NTUEE-ESLab/2018Fall-PointBlank/presentation.pdf

# PointBlank

### B04901036 林厚均 B04901165 陳致維

# Outline

### - Motivation - Goals - Methods

- Qt (for GUI)
- Bluetooth Low Energy (for communication)
- Motion Sensor (for mouse position)

### - Results - Reference

# Motivation

### - Replace traditional laser pointer - Safer and more versatile - Inspired by a commercial product

# Goals

### - Determine pointer’s projection on screen without cameras and physical (light) markers - Basic functions of a presentation pointer

- Next slide
- Previous slide
- Display the position of the projection

### - Additional features

- Control mouse position
- Simulate mouse click
- Act as magnifying glass
- Customization

# Methods (GUI)

### - Using Qt - Creates a full screen transparent window that ignores keyboard and mouse inputs - Receives coordinates from the pointer and draws on the screen according to the current mode - Also provides user interface for customization as a seperate program

# Four modes (1)

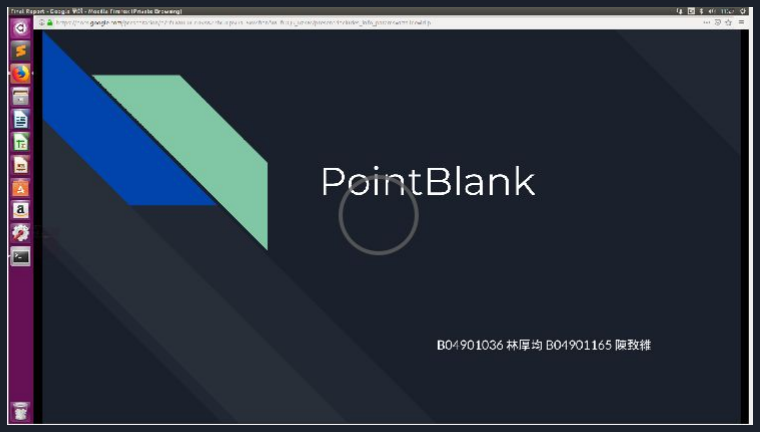
[picture p15: figure]

### 1. drawEllipse()

- center coordinates, radius
- using pen width, pen color

# Four modes (2)

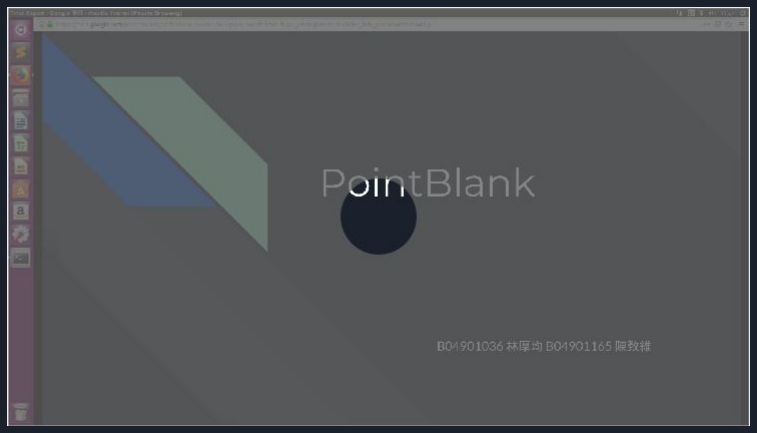
[picture p16: figure]

### 1. fillRect()

- fill the whole screen with color

### 2. drawEllipse()

- fill with color (0,0,0,0)
- full transparent circle around mouse position

# Four modes (3)

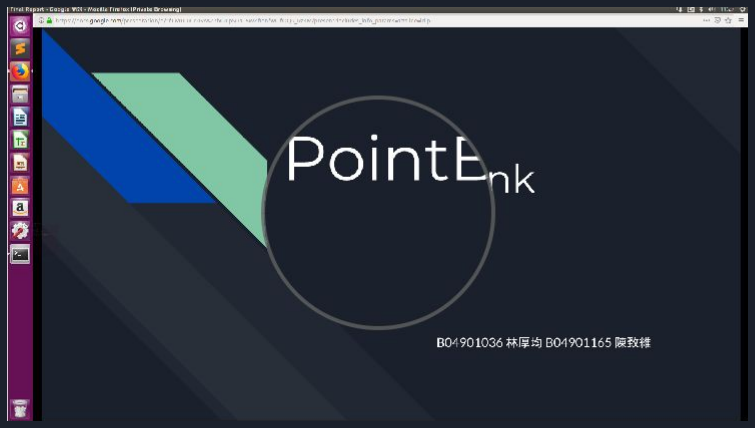
[picture p17: figure]

### 1. grabWindow()

- take screenshot when button is pressed

### 2. scale and reposition the image 3. setClipRegion

- the scaled image only appears inside the circle

# Four modes (4)

### - The previous modes are for slideshows

- their left and right buttons correspond to keyboard UP and DOWN respectively

### - This mode simulates mouse function

- with mouse left click and right click

# Customization

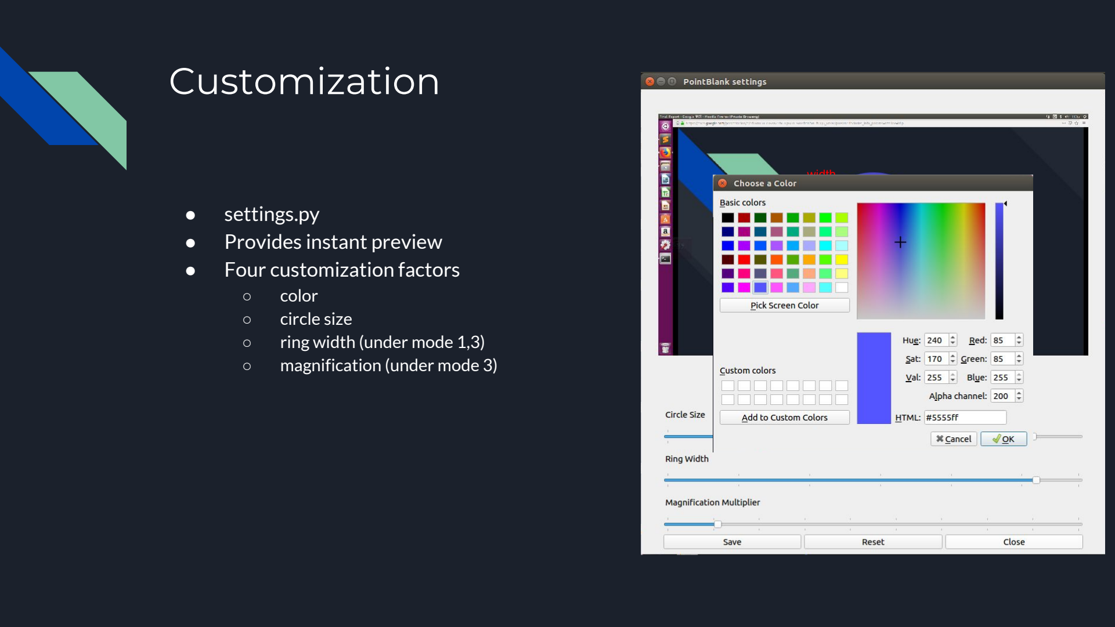
[picture p18: page 10]

### - settings.py - Provides instant preview - Four customization factors

- color
- circle size
- ring width (under mode 1,3)
- magnification (under mode 3)

size

width

# Methods (Bluetooth)

### - Using Qt for central

- Discover advertising Raspberry Pi and connect to it
- Enable notifications for Position and Buttons characteristics
- Update GUI whenever a notification is received

### - Using bluez for peripheral

- Advertisement
- Service: PointBlank
- Characteristics: Position, Buttons
- Position returns (x, y) with x and y being floats between 0 and 1
■ referring to the boundaries of the screen
- Buttons returns an integer indicating which button is pressed or released

# Establishing Bluetooth Connection

### 1. QBluetoothDeviceDiscoveryAgent.start()

- Search for nearby low energy services

### 2. QLowEnergyController.connectToDevice()

- connnect to device with service uuid “00003125-0000-1000-8000-00805f9b34fb”

### 3. QLowEnergyController.discoverServices() 4. QLowEnergyService.discoverDetails()

- For each service, in this case we only have one

### 5. Write “0x0100” to the descriptors of Position and Buttons characteristic

- to enable notification

# Methods (Motion Sensor)

### - MPU9250 - Self-defined operation state:

- Sleep: all sensor power off
- Active: read gyroscope and accelerometer at ~500Hz
- Switch by button

### - Data process:

- Represent orientation: frame and transformation
- Update orientation: 6-axis data fusion
- Initialize orientation
- Reduce vibration: vibration from hand and sensor noise

# Orientation Representation

### - Recording the difference between

- Sensor frame
- Earth frame

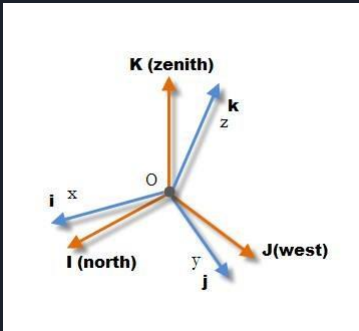
[picture p19: figure]

### by some representation

### - Rotation matrix The same as recording the three axes of earth frame in sensor frame

### - Numerical error Cannot ensure the three axes keep perpendicular to each other after several update

# Roll-Pitch-Yaw (Euler Angles)

### - Simple representation three rotations apply on x, y, z axis sequentially

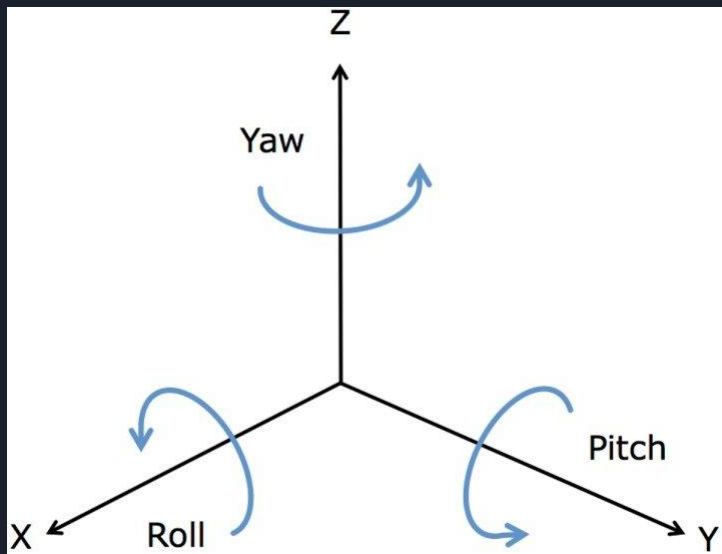
[picture p20: figure]

### - Consistent to gyroscope output

### - Computational demanding: one vector transformation needs

- three rotation matrix multiplication
- and lots of sine, cosine computation

# Quarternion

### - Euler rotation theorem: Any 3D rotation can be represent as a rotation along some axis

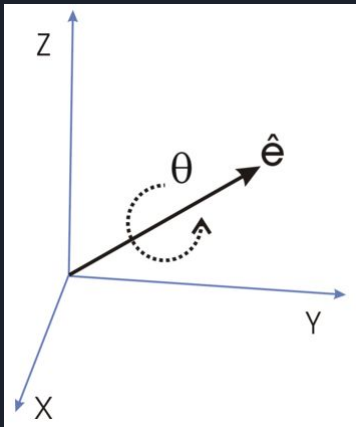
[picture p21: figure]

### - Quarternion catch this property by an indirect way: [cos θ/2, ex

### sin θ/2, ey

### sin θ/2, ez

### sin θ/2]

### - All rotation operations become linear

- operations like rotation matrix
- smaller numerical error
- faster computation

# Quarternion Operation

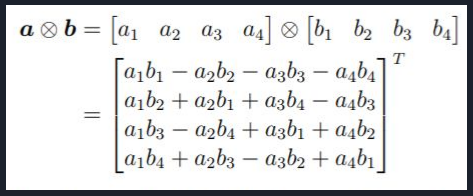
[picture p22: figure]

### - Extention of complex number:

- i²

= j²

= k²
= -1
- ij = k
- [w, x, y, z] = w + xi + yj + zk
- a* = [a1

, -a2

, -a3

, -a4

]

### - Unit quarternion and 3D rotation are isomorphic:

- | Quarternion | can represent rotation from
frame A to frame B

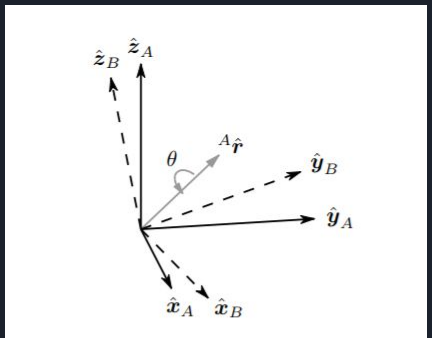
[picture p23: figure]

- sequential:
- | transformation: | , | , v = [0, v1 , v2

, v3

]
- | backward: | q*

### - Both Unity and OpenGL support quarternion

# Update Orientation

### - 6-axis data fusion

- Gyroscope has drift problem from integral
- Accelerometer itself cannot generate a sensor frame

### - Madgwick orientation filter

- Quarternion representation
- use fixed vector (gravity) to adjust gyroscope

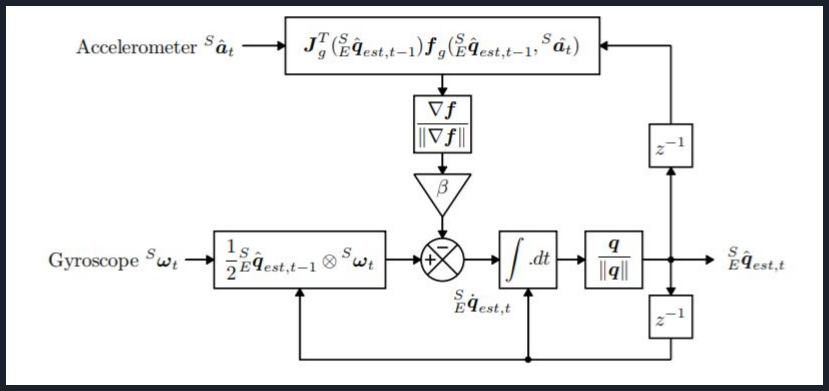
[picture p24: figure]

# Initialize Orientation

### - Problem

- Madgwick filter assumes gravity is on positive z-axis
- Correlation between initial sensor frame and horizontal movement

### - Goal

- Pointer usage is independent of pitch angle and roll angle
- x-axis: front direction (pointer direction)
- y-axis: horizontal direction
- z-axis: vertical direction

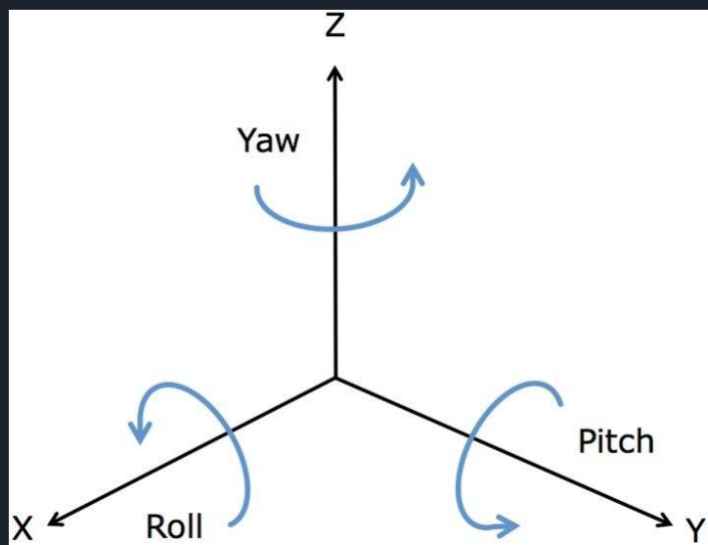
[picture p25: figure]

# Initialize Orientation (Cont.)

### - Add a beginning body frame - From sensor frame to beginning frame: roll angle

- horizontal direction: outer product of pointer direction and gravity
- compute the angle between y-axis and horizontal direction
- correct roll angle

### - From beginning frame to earth frame: pitch angle

- compute the angle between z-axis and vertical direction (gravity)
- correct pitch angle

### - Update sensor-to-earth quarternion by Madgwick filter - Compute the difference between pointer direction and beginning direction in beginning frame

# Reduce Vibration

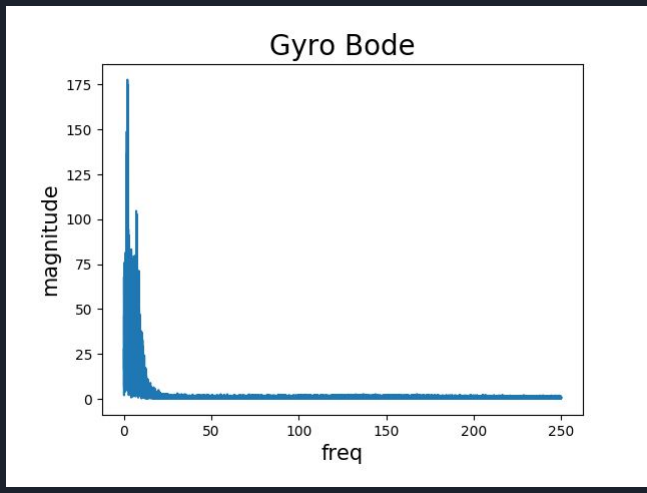
[picture p26: figure]

### - Problem

- Hand natural vibration (1~10Hz)
- Sensor white noise

### - Goal

- Minimize the vibration of the pointer output
- Reasonable response time (negligible delay)
- Trade-off

### - Solution

- SImple first order IIR filter
- output[n] = 0.02 * input[n] + 0.98 * output[n-1]
- Reduce ~70% vibration
- Delay: ~0.1s

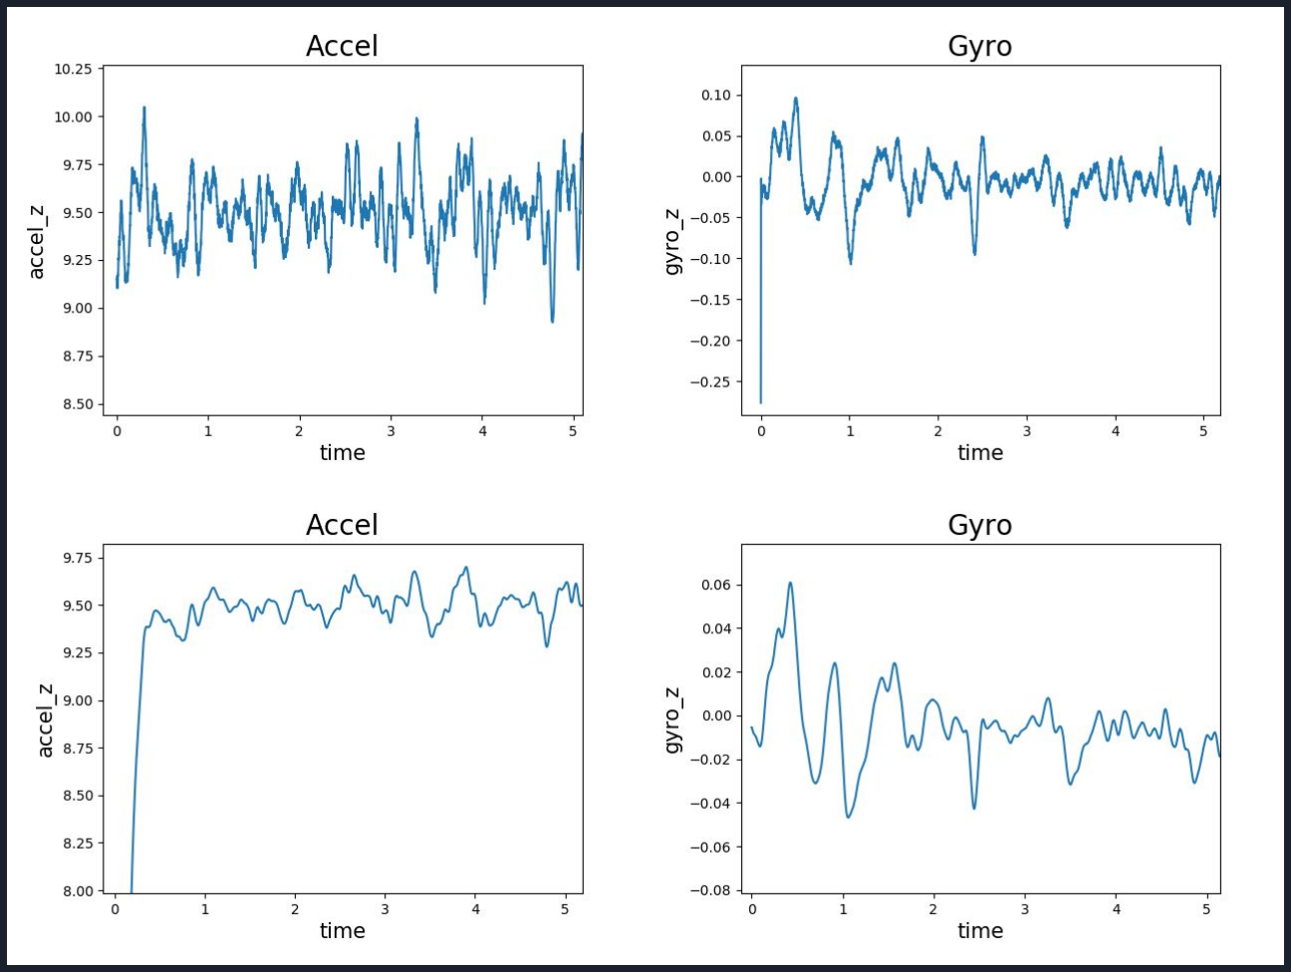
[picture p27: figure]

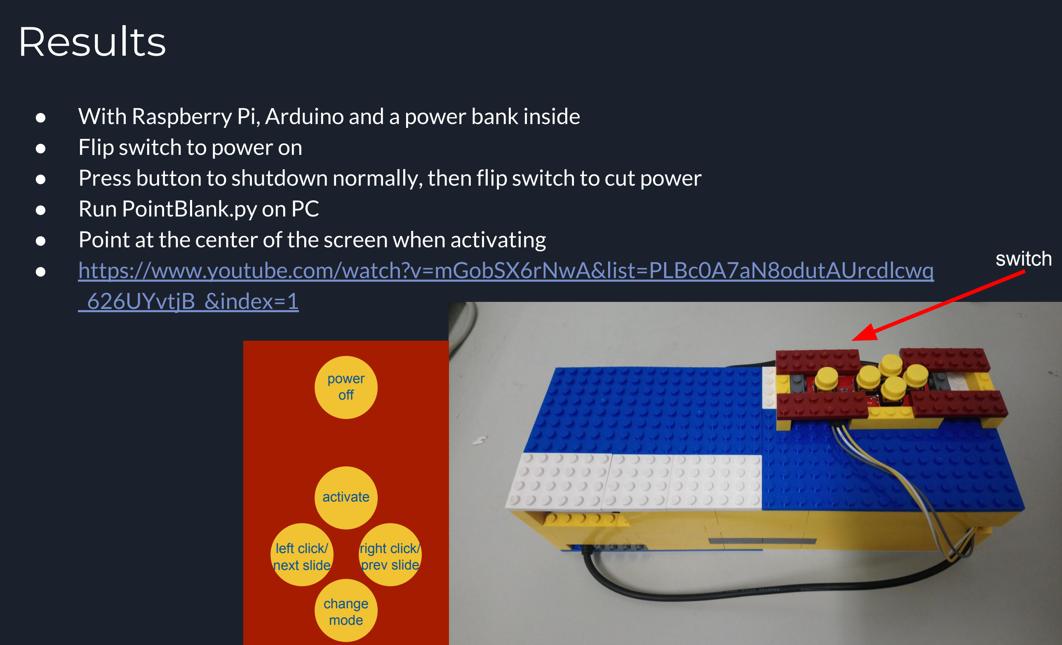
[picture p28: figure]
● Flip switch to power on; ● Run PointBlank.py on PC; _626UYvtjB_&index=1; Results; power off; change mode; left click/ next slide; right click/ prev slide; activate; switch

### - With Raspberry Pi, Arduino and a power bank inside

### - Press button to shutdown normally, then flip switch to cut power

### - Point at the center of the screen when activating - https://www.youtube.com/watch?v=mGobSX6rNwA&list=PLBc0A7aN8odutAUrcdlcwq

# Reference

### - http://doc.qt.io/ - Example codes in bluez folder - MPU 9250 Datasheet - Sebastian O. H. Madgwick, “Estimation of IMU and MARG orientation using a gradient descent algorithm”, 2011 IEEE International Conference on Rehabilitation Robotics

# Thank you for your attention
