NTUEE-ESLab/2018Fall-PointBlank/rpi/bluez_example.py

#!/usr/bin/python

import dbus
import dbus.exceptions
import dbus.mainloop.glib
import dbus.service

import array
import gobject

import random
import struct

BLUEZ_SERVICE_NAME = 'org.bluez'
LE_ADVERTISING_MANAGER_IFACE = 'org.bluez.LEAdvertisingManager1'
DBUS_OM_IFACE = 'org.freedesktop.DBus.ObjectManager'
DBUS_PROP_IFACE = 'org.freedesktop.DBus.Properties'

LE_ADVERTISEMENT_IFACE = 'org.bluez.LEAdvertisement1'

GATT_MANAGER_IFACE = 'org.bluez.GattManager1'

GATT_SERVICE_IFACE = 'org.bluez.GattService1'
GATT_CHRC_IFACE =    'org.bluez.GattCharacteristic1'
GATT_DESC_IFACE =    'org.bluez.GattDescriptor1'

class InvalidArgsException(dbus.exceptions.DBusException):
    _dbus_error_name = 'org.freedesktop.DBus.Error.InvalidArgs'

class NotSupportedException(dbus.exceptions.DBusException):
    _dbus_error_name = 'org.bluez.Error.NotSupported'

class NotPermittedException(dbus.exceptions.DBusException):
    _dbus_error_name = 'org.bluez.Error.NotPermitted'

class InvalidValueLengthException(dbus.exceptions.DBusException):
    _dbus_error_name = 'org.bluez.Error.InvalidValueLength'

class FailedException(dbus.exceptions.DBusException):
    _dbus_error_name = 'org.bluez.Error.Failed'


class Advertisement(dbus.service.Object):
    PATH_BASE = '/org/bluez/example/advertisement'

    def __init__(self, bus, index, advertising_type):
        self.path = self.PATH_BASE + str(index)
        self.bus = bus
        self.ad_type = advertising_type
        self.service_uuids = None
        self.manufacturer_data = None
        self.solicit_uuids = None
        self.service_data = None
        self.local_name = None
        self.include_tx_power = None
        dbus.service.Object.__init__(self, bus, self.path)

    def get_properties(self):
        properties = dict()
        properties['Type'] = self.ad_type
        if self.service_uuids is not None:
            properties['ServiceUUIDs'] = dbus.Array(self.service_uuids,
                                                    signature='s')
        if self.solicit_uuids is not None:
            properties['SolicitUUIDs'] = dbus.Array(self.solicit_uuids,
                                                    signature='s')
        if self.manufacturer_data is not None:
            properties['ManufacturerData'] = dbus.Dictionary(self.manufacturer_data, signature='qay')

        if self.service_data is not None:
            properties['ServiceData'] = dbus.Dictionary(self.service_data, signature='say')

        if self.local_name is not None:
            properties['LocalName'] = dbus.String(self.local_name)

        if self.include_tx_power is not None:
            properties['IncludeTxPower'] = dbus.Boolean(self.include_tx_power)

        return {LE_ADVERTISEMENT_IFACE: properties}

    def get_path(self):
        return dbus.ObjectPath(self.path)

    def add_service_uuid(self, uuid):
        if not self.service_uuids:
            self.service_uuids = []
        self.service_uuids.append(uuid)

    def add_solicit_uuid(self, uuid):
        if not self.solicit_uuids:
            self.solicit_uuids = []
        self.solicit_uuids.append(uuid)

    def add_manufacturer_data(self, manuf_code, data):
        if not self.manufacturer_data:
            self.manufacturer_data = dict()
        self.manufacturer_data[manuf_code] = data

    def add_service_data(self, uuid, data):
        if not self.service_data:
            self.service_data = dict()
        self.service_data[uuid] = data

    def add_local_name(self, name):
        if not self.local_name:
            self.local_name = ""
        self.local_name = dbus.String(name)

    @dbus.service.method(DBUS_PROP_IFACE,
                         in_signature='s',
                         out_signature='a{sv}')
    def GetAll(self, interface):
        print 'GetAll'
        if interface != LE_ADVERTISEMENT_IFACE:
            raise InvalidArgsException()
        print 'returning props'
        return self.get_properties()[LE_ADVERTISEMENT_IFACE]

    @dbus.service.method(LE_ADVERTISEMENT_IFACE,
                         in_signature='',
                         out_signature='')
    def Release(self):
        print '%s: Released!' % self.path

class Application(dbus.service.Object):
    """
    org.bluez.GattApplication1 interface implementation
    """
    PATH_BASE = '/org/bluez/example/application'

    def __init__(self, bus):
        self.path = self.PATH_BASE
        self.services = []
        dbus.service.Object.__init__(self, bus, self.path)
        self.add_service(HeartRateService(bus, 0))
        self.add_service(BatteryService(bus, 1))
        self.add_service(TestService(bus, 2))

    def get_path(self):
        return dbus.ObjectPath(self.path)

    def add_service(self, service):
        self.services.append(service)

    @dbus.service.method(DBUS_OM_IFACE, out_signature='a{oa{sa{sv}}}')
    def GetManagedObjects(self):
        response = {}
        print('GetManagedObjects')

        for service in self.services:
            response[service.get_path()] = service.get_properties()
            chrcs = service.get_characteristics()
            for chrc in chrcs:
                response[chrc.get_path()] = chrc.get_properties()
                descs = chrc.get_descriptors()
                for desc in descs:
                    response[desc.get_path()] = desc.get_properties()

        return response

class Service(dbus.service.Object):
    PATH_BASE = '/org/bluez/example/service'

    def __init__(self, bus, index, uuid, primary):
        self.path = self.PATH_BASE + str(index)
        self.bus = bus
        self.uuid = uuid
        self.primary = primary
        self.characteristics = []
        dbus.service.Object.__init__(self, bus, self.path)

    def get_properties(self):
        return {
                GATT_SERVICE_IFACE: {
                        'UUID': self.uuid,
                        'Primary': self.primary,
                        'Characteristics': dbus.Array(
                                self.get_characteristic_paths(),
                                signature='o')
                }
        }

    def get_path(self):
        return dbus.ObjectPath(self.path)

    def add_characteristic(self, characteristic):
        self.characteristics.append(characteristic)

    def get_characteristic_paths(self):
        result = []
        for chrc in self.characteristics:
            result.append(chrc.get_path())
        return result

    def get_characteristics(self):
        return self.characteristics

    @dbus.service.method(DBUS_PROP_IFACE,
                         in_signature='s',
                         out_signature='a{sv}')
    def GetAll(self, interface):
        if interface != GATT_SERVICE_IFACE:
            raise InvalidArgsException()

        return self.get_properties[GATT_SERVICE_IFACE]

    @dbus.service.method(DBUS_OM_IFACE, out_signature='a{oa{sa{sv}}}')
    def GetManagedObjects(self):
        response = {}
        print('GetManagedObjects')

        response[self.get_path()] = self.get_properties()
        chrcs = self.get_characteristics()
        for chrc in chrcs:
            response[chrc.get_path()] = chrc.get_properties()
            descs = chrc.get_descriptors()
            for desc in descs:
                response[desc.get_path()] = desc.get_properties()

        return response


class Characteristic(dbus.service.Object):
    def __init__(self, bus, index, uuid, flags, service):
        self.path = service.path + '/char' + str(index)
        self.bus = bus
        self.uuid = uuid
        self.service = service
        self.flags = flags
        self.descriptors = []
        dbus.service.Object.__init__(self, bus, self.path)

    def get_properties(self):
        return {
                GATT_CHRC_IFACE: {
                        'Service': self.service.get_path(),
                        'UUID': self.uuid,
                        'Flags': self.flags,
                        'Descriptors': dbus.Array(
                                self.get_descriptor_paths(),
                                signature='o')
                }
        }

    def get_path(self):
        return dbus.ObjectPath(self.path)

    def add_descriptor(self, descriptor):
        self.descriptors.append(descriptor)

    def get_descriptor_paths(self):
        result = []
        for desc in self.descriptors:
            result.append(desc.get_path())
        return result

    def get_descriptors(self):
        return self.descriptors

    @dbus.service.method(DBUS_PROP_IFACE,
                         in_signature='s',
                         out_signature='a{sv}')
    def GetAll(self, interface):
        if interface != GATT_CHRC_IFACE:
            raise InvalidArgsException()

        return self.get_properties[GATT_CHRC_IFACE]

    @dbus.service.method(GATT_CHRC_IFACE, out_signature='ay')
    def ReadValue(self):
        print('Default ReadValue called, returning error')
        raise NotSupportedException()

    @dbus.service.method(GATT_CHRC_IFACE, in_signature='ay')
    def WriteValue(self, value):
        print('Default WriteValue called, returning error')
        raise NotSupportedException()

    @dbus.service.method(GATT_CHRC_IFACE)
    def StartNotify(self):
        print('Default StartNotify called, returning error')
        raise NotSupportedException()

    @dbus.service.method(GATT_CHRC_IFACE)
    def StopNotify(self):
        print('Default StopNotify called, returning error')
        raise NotSupportedException()

    @dbus.service.signal(DBUS_PROP_IFACE,
                         signature='sa{sv}as')
    def PropertiesChanged(self, interface, changed, invalidated):
        pass


class Descriptor(dbus.service.Object):
    def __init__(self, bus, index, uuid, flags, characteristic):
        self.path = characteristic.path + '/desc' + str(index)
        self.bus = bus
        self.uuid = uuid
        self.flags = flags
        self.chrc = characteristic
        dbus.service.Object.__init__(self, bus, self.path)

    def get_properties(self):
        return {
                GATT_DESC_IFACE: {
                        'Characteristic': self.chrc.get_path(),
                        'UUID': self.uuid,
                        'Flags': self.flags,
                }
        }

    def get_path(self):
        return dbus.ObjectPath(self.path)

    @dbus.service.method(DBUS_PROP_IFACE,
                         in_signature='s',
                         out_signature='a{sv}')
    def GetAll(self, interface):
        if interface != GATT_DESC_IFACE:
            raise InvalidArgsException()

        return self.get_properties[GATT_CHRC_IFACE]

    @dbus.service.method(GATT_DESC_IFACE, out_signature='ay')
    def ReadValue(self):
        print ('Default ReadValue called, returning error')
        raise NotSupportedException()

    @dbus.service.method(GATT_DESC_IFACE, in_signature='ay')
    def WriteValue(self, value):
        print('Default WriteValue called, returning error')
        raise NotSupportedException()
